power-max/Three-Half-Bridges/(threads)

Thread 1 (2020-09-15):

Add RC snubber network

power-max, 2020-09-15:
While Body diode and D3 and D5 clamp the maximum voltage at the output to [GND - VCC], it is still necessary to prevent high dv/dt causing excessive current to flow through Cgd (See: miller effect) and such an RC network can help limit the dv/dt observed across Vds of both FETs during operation when driving an inductive load.

Thread 2 (2020-09-15):

Place MOSFETs closer to heatsinks

power-max, 2020-09-15:
Found that the MOSFETs need to have the legs bend forward a bit to sit flush against the heatsink. Not a big deal but does make it a bit harder to assemble.

Thread 3 (2020-09-15):

Add descriptive silkscreen

power-max, 2020-09-15:
Forgot to add silkscreen designations.

* VCC connection (or should change to using VDD term since this is mostly FET and CMOS...)
* GND connection
* OUT connection

* Label FAN connection
* Label the signal and 12V connections

Closed 2024-11-10.

Thread 4 (2024-11-18):

Safety note

power-max, 2024-11-18:
Add note on PCB file and schematic that strictly TO-247 should be used and that TO-3P is not a great choice unless all three half bridges will be run in phase with each-other. There is not much clearance between adjacent half bridges and the exposed metal tab around the corners of the TO-3P causes an issue. SOT83 / TO218 should absolutely not be used!!!! TO218 is retarded. Not only does it have that issue but the smaller plastic package prevents the sandwich structure from providing any pressure on the tab.

Thread 5 (2024-11-19):

Designators update

power-max, 2024-11-19:
Replace D with Z for zener diodes, makes it easier to identify LED vs Zener diode footprint.

Closed 2024-11-25.

Thread 7 (2024-11-20):

Fix transformer footprint

power-max, 2024-11-20:
Update footprint for smaller transformer

power-max, 2024-11-25:
choose a less shitty transformer with better volt-time product or rethink driver mayhaps

Closed 2024-11-25.

Thread 8 (2024-11-20):

Change output rectification to double output voltage

power-max, 2024-11-20:
6505 and similar have 5V max input, update design to use several 6505's and 5V only primary side (eliminate 12V input)

Closed 2024-11-25.

Thread 9 (2024-11-20):

Add Pgood signal to 5V on primary and low voltage secondary

power-max, 2024-11-20:
In the event the 5V primary goes below UV lockout (something blew up?) Sends a signal back to controller to indicate fault condition

Thread 10 (2024-11-22):

Wrong pinout all LDOs

power-max, 2024-11-22:
So it turns out the pinout for the 78L05 in a SOT89 footprint is different from that of the AMS1117-5, and I can't find AMS1117-5 available in a SOT89, only a SOT-223. Guhhhhhh....... So update to feature a 78L05 instead.

Also, move regulators for the digital isolator ICs closer to them, no need to take precious space where the H bridge outputs are.

Closed 2024-11-25.

Thread 11 (2024-11-23):

Connect gate driver EN pins

power-max, 2024-11-23:
Add connections to gate driver ENABLE pins to enable or disable the gate driver provided via a solderbridge selectable footprint

Closed 2024-11-25.

Thread 13 (2024-11-24):

Wrong transformer footprint

power-max, 2024-11-24:
Gonna use the EPC3668G moving forward.

power-max, 2024-11-24:
and whatever transformer happens to fit that footprint :P

Closed 2024-11-25.

Thread 14 (2024-11-25):

soldermask removal on hall current sensors

power-max, 2024-11-25:
Passing over 60A through 2 pins of a SOIC8 is dodgy as is! Remove the solder mask on the 3 current sense

Closed 2024-11-25.

Thread 15 (2024-12-05):

Move OUT 1 2 3 designators

power-max, 2024-12-05:
With the new footprint for M5 terminal blocks, silkscreen can be moved inside the footprint to prevent clipping of text.

Thread 16 (2024-12-05):

Fix footprint for terminal blocks

power-max, 2024-12-05:
The slots for each through hole need to be rotated 90 degrees to fit them properly.

Thread 17 (2024-12-05):

update schottky diode footprint to SOT23-3

power-max, 2024-12-05:
the footprint is a bit small as I am populating the board, requiring me to solder blob it in place. I think I accidentally used the wrong footprint for it in the project. Update the schematic, BOM, and PCB file.

Thread 18 (2024-12-05):

LED footprint

power-max, 2024-12-05:
Change cap 0805 footprint (unpolarized) to diode 0805 footprint so polarity is known when hand soldering.

Thread 19 (2024-12-13):

Feature add: voltage sense

power-max, 2024-12-13:
Add voltage sense to output to allow more motor control algorithms

Sensorless 6 step block comutation of BLDC and PMSM can be done by using specialized SVM where ⅔ phases are driven and undriven phase is voltage sense waiting for zero or ½VCC crossing.

Thread 20 (2024-12-18):

Move TO243 high and low side closer together

power-max, 2024-12-18:
The packages tend to extend a bit beyond the edge of the heatsink. Also to reduce impedance between low side switch and high side body diode and vice versa.

Thread 23 (2025-01-02):

Change position of mounting screws to support mounting of a PWM computer chassis fan

power-max, 2025-01-02:
The 88mm hole spacing is quite close to a common standard 92mm PC case fan featuring 82.5mm hole spacing, allowing standoffs to be mounted and a fan mounted.

Thread 24 (2025-03-22):

add design rules for voltage domains

power-max, 2025-03-22:
Add design rules for the HV and LV voltage domains to enforce adequate creepage and clearance ensuring at least some basic level of safety. (safety last!)
