power-max/Three-Half-Bridges/pdf/three_half_bridges.pdf

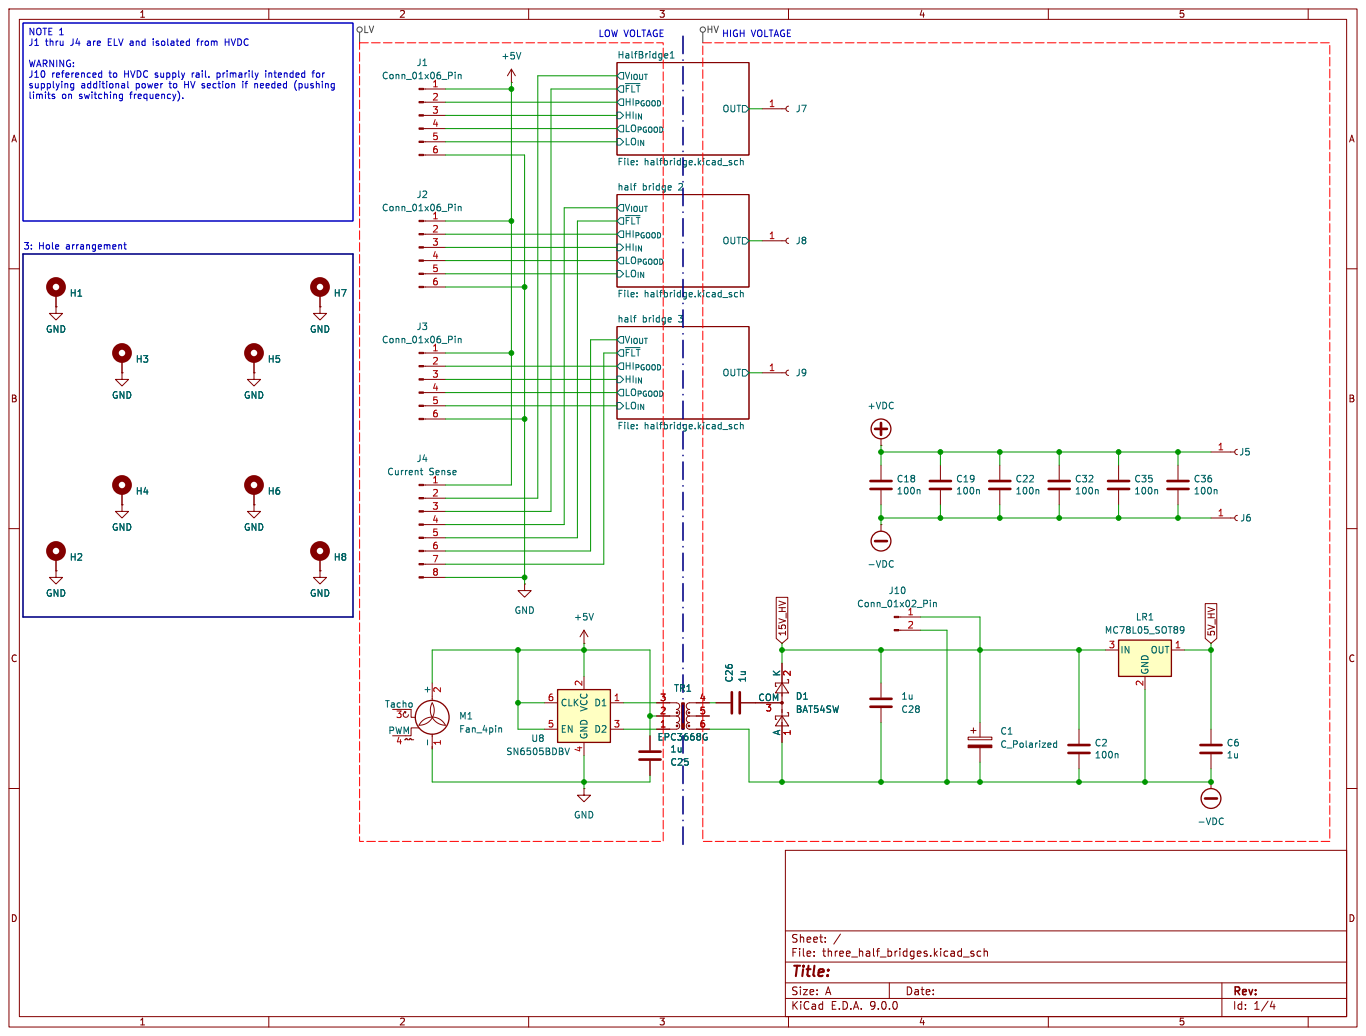
[picture p1: page 1]

~{FLT} half bridge 3 File: halfbridge.kicad_schOUT HI_{IN}
LO_{PGOOD}

Id: 1/4 Title: File: three_half_bridges.kicad_sch Sheet: /

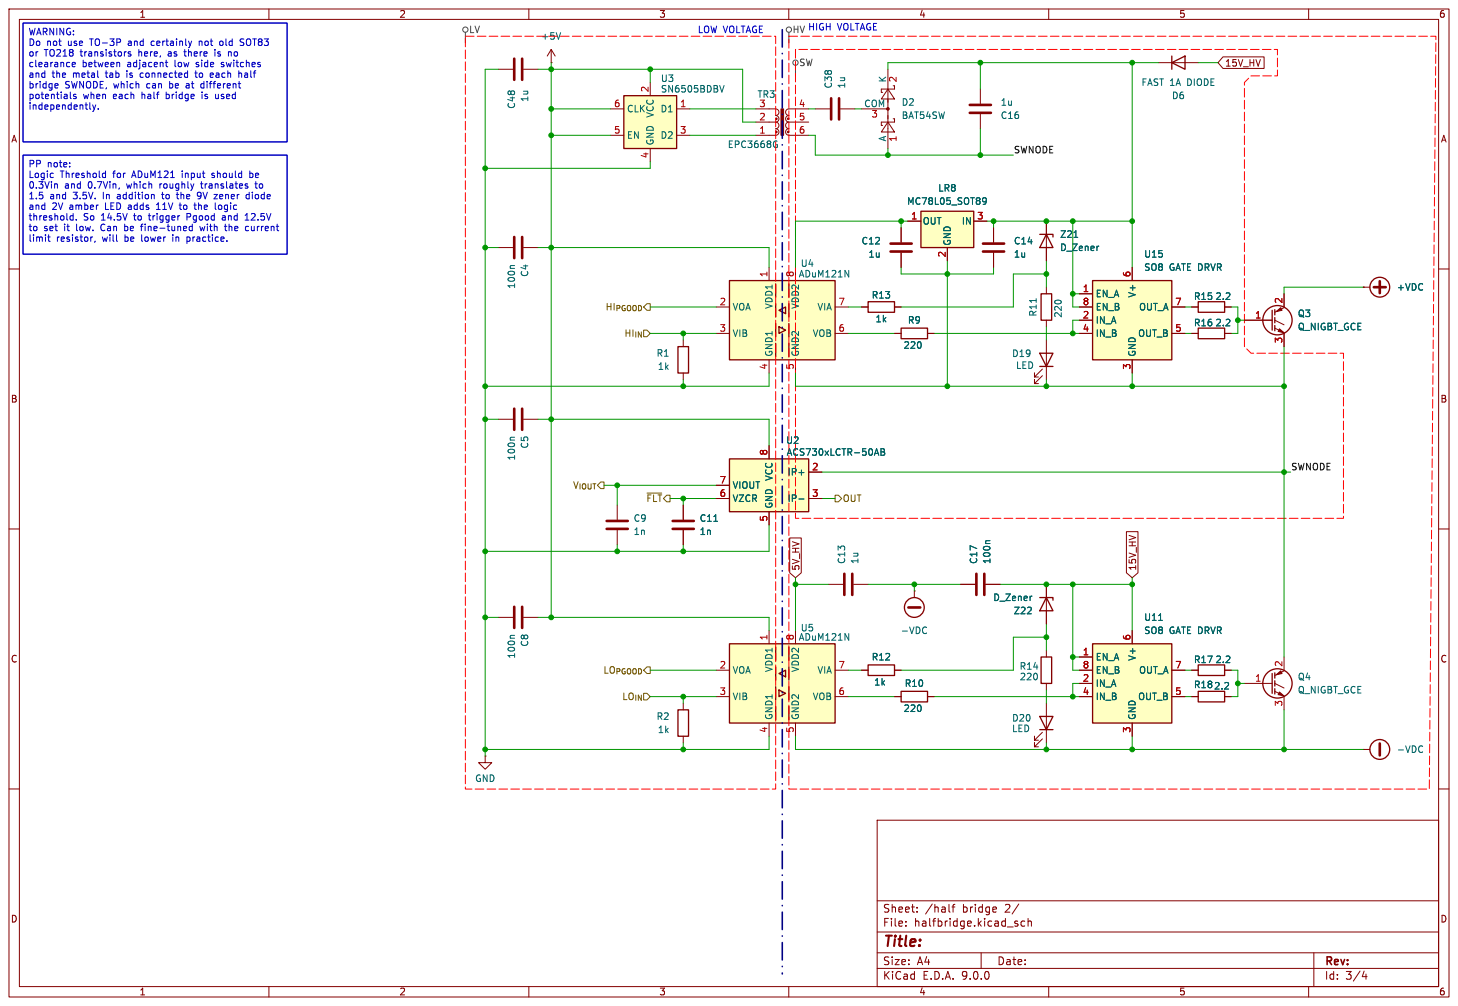
[picture p2: page 2]

5 VIA 7 VOB 6 U4 ADuM121NC38 1u D6 FAST 1A DIODE R9

PP note: Logic Threshold for ADuM121 input should be

and 2V amber LED adds 11V to the logic

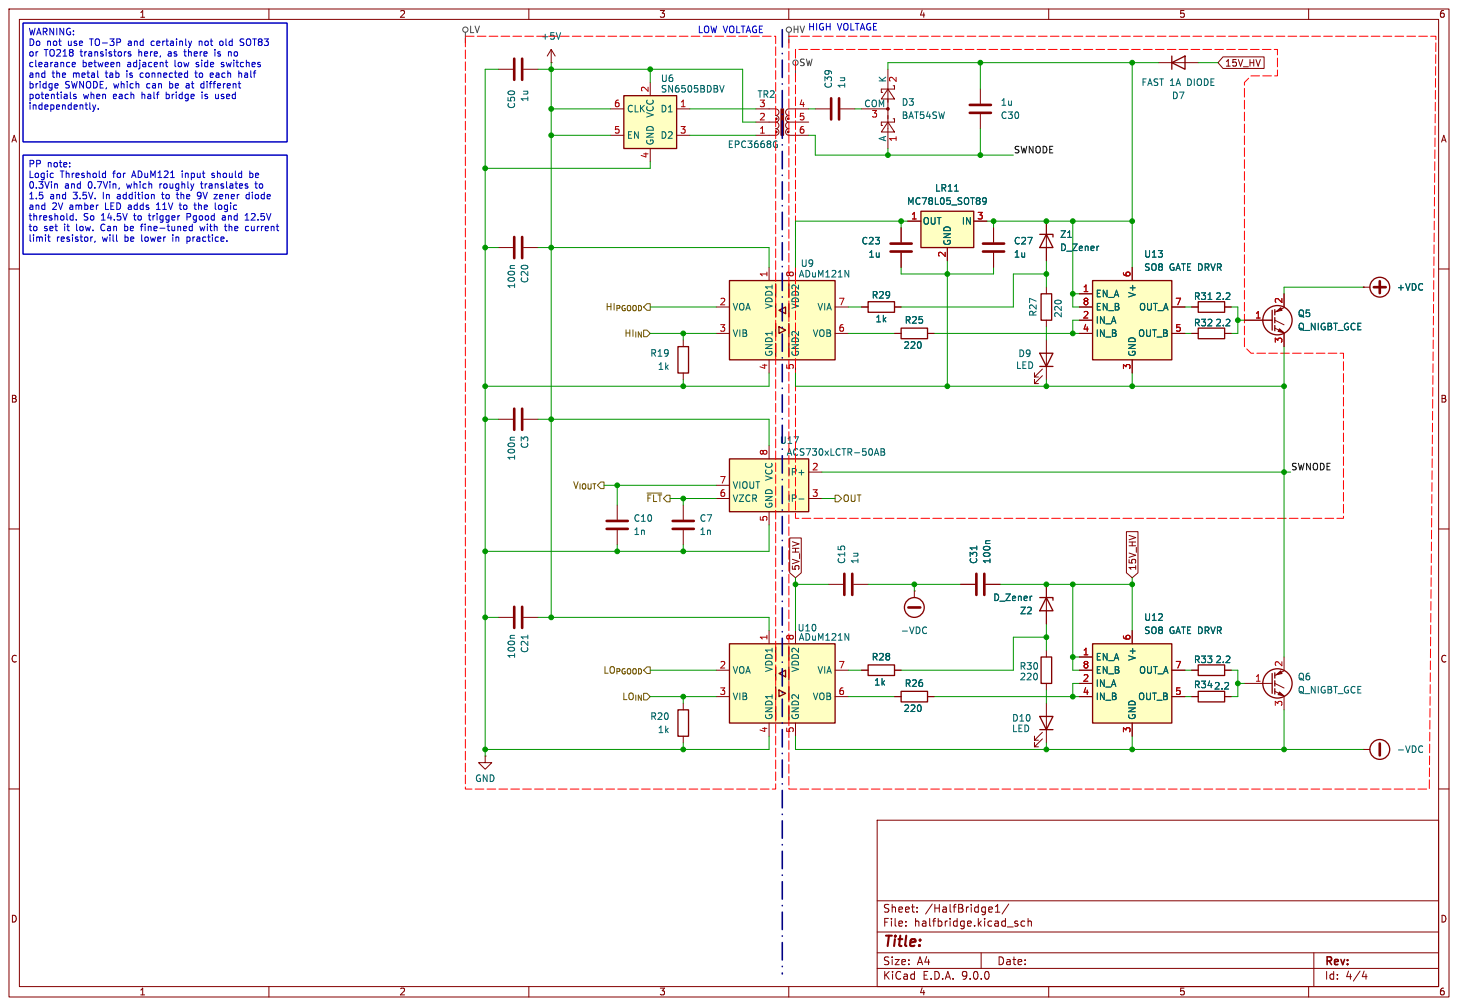
[picture p3: page 3]

4 D1 1 D2 3 U6SN6505BDBV R34 2.2 C20 100n R20
Id: 4/4 Title: File: halfbridge.kicad_sch Sheet: /HalfBridge1/ C501u
1u GND

PP note: Logic Threshold for ADuM121 input should be

and 2V amber LED adds 11V to the logic

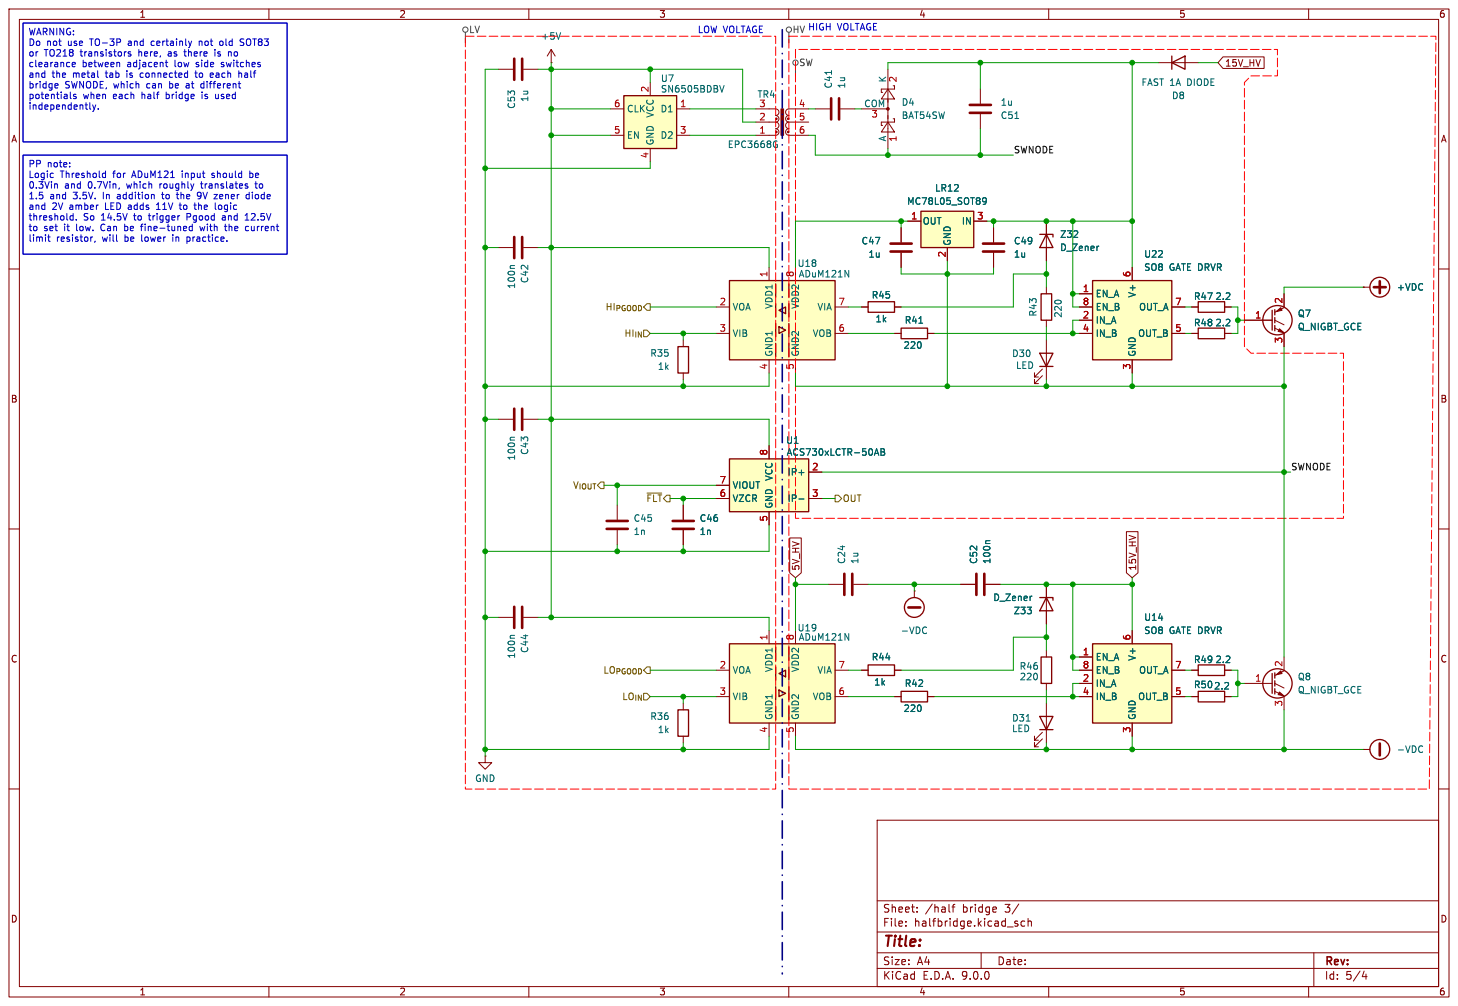
[picture p4: page 4]

PP note: Logic Threshold for ADuM121 input should be

and 2V amber LED adds 11V to the logic
