power-max/Three-Half-Bridges/pdf/three_half_bridges-B_Cu.pdf

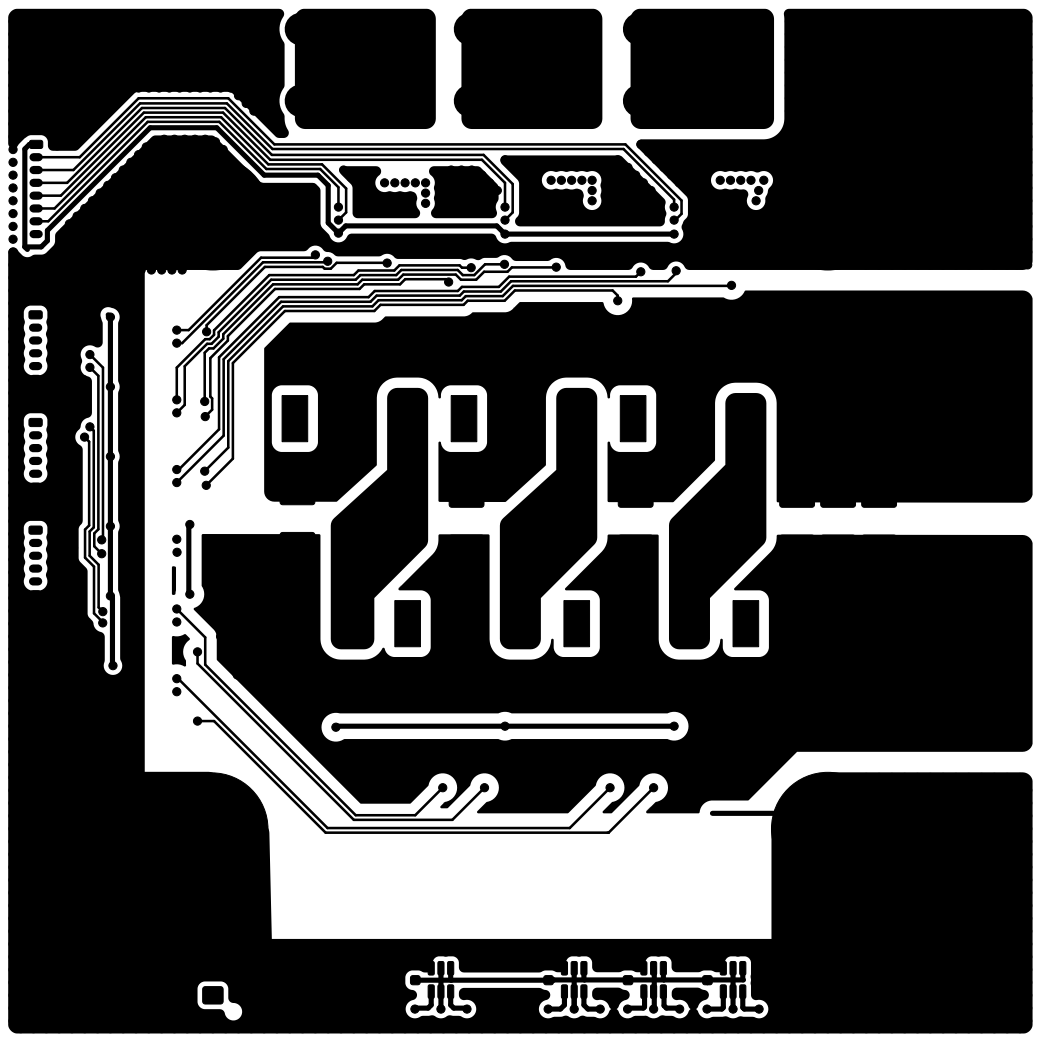
[picture p5: page 1]
