power-max/Three-Half-Bridges/pdf/three_half_bridges-B_Mask.pdf

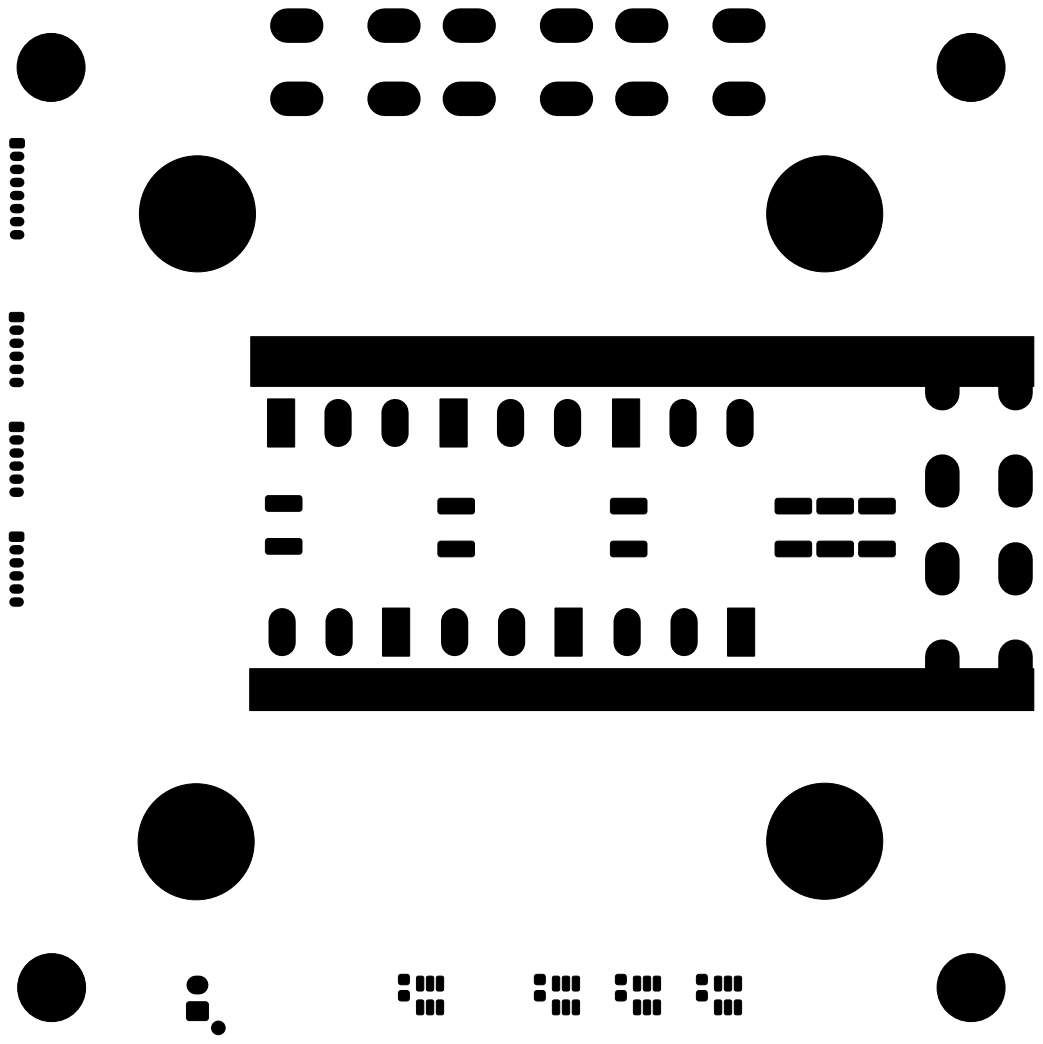
[picture p6: page 1]
