power-max/Three-Half-Bridges/pdf/three_half_bridges-B_Paste.pdf

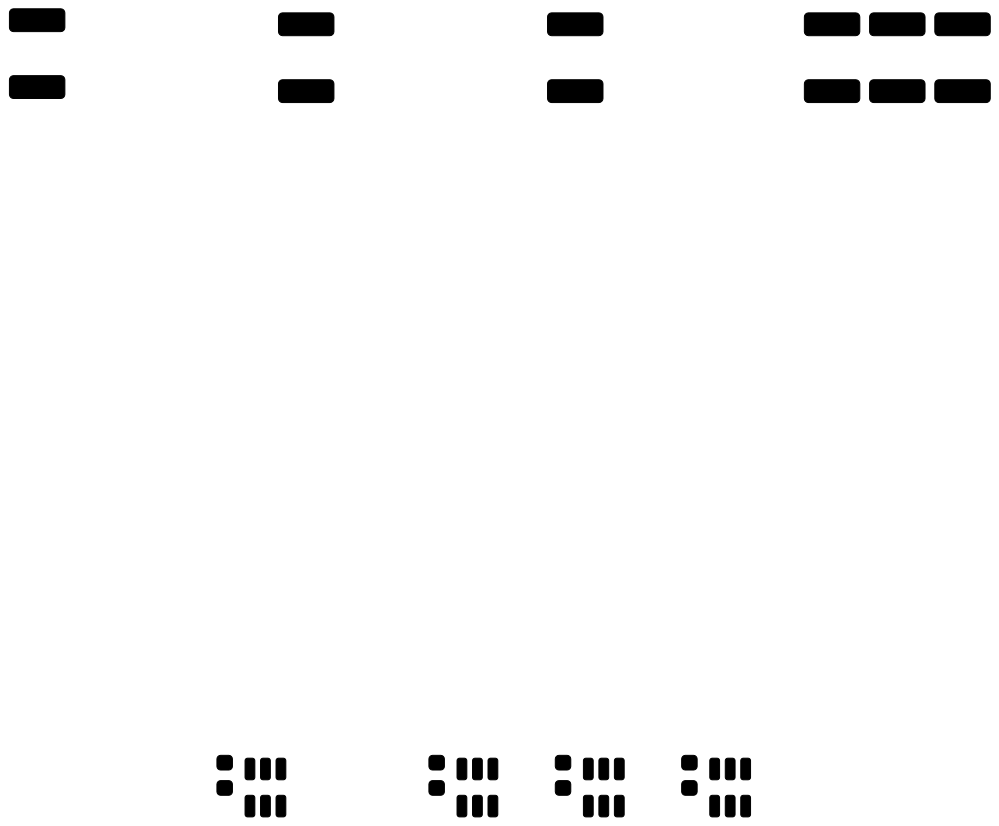
[picture p7: page 1]
