power-max/Three-Half-Bridges/pdf/three_half_bridges-B_Silkscreen.pdf

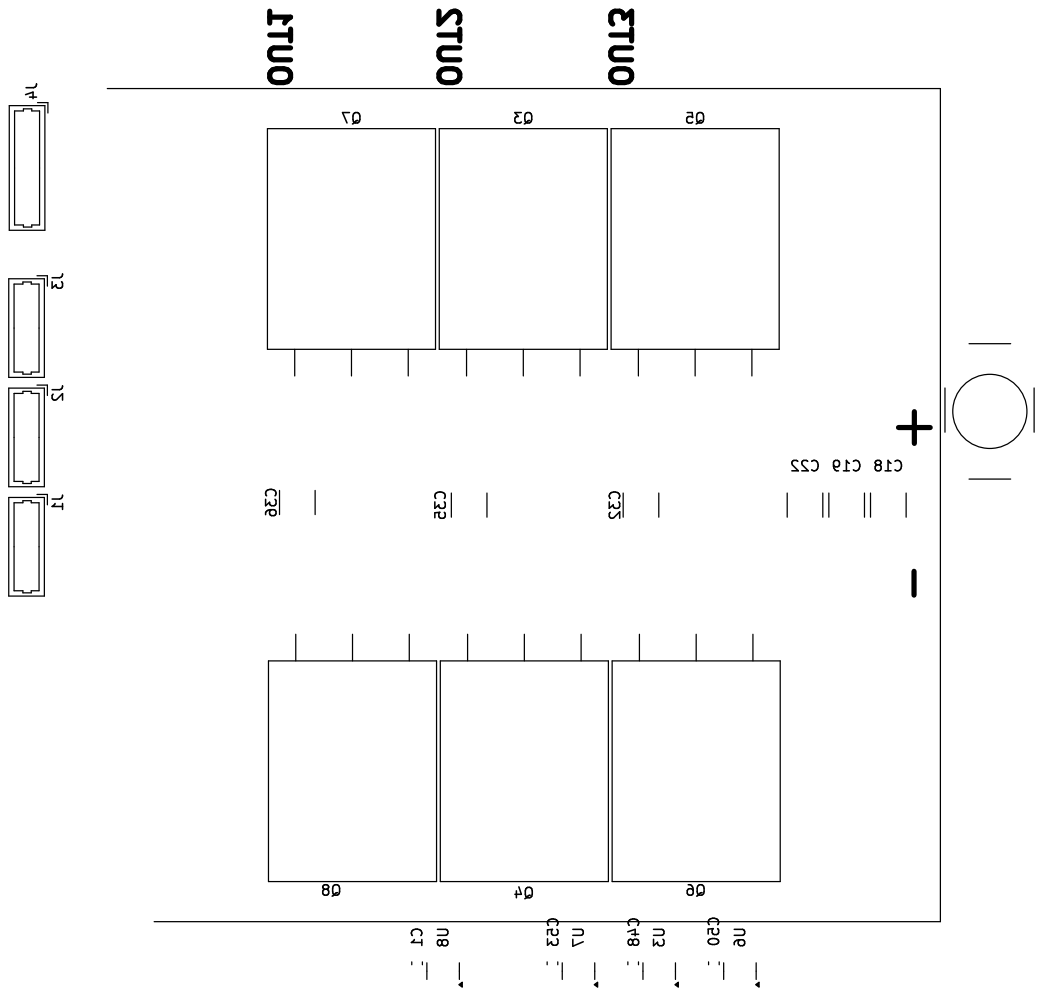
[picture p8: page 1]
