power-max/Three-Half-Bridges/pdf/three_half_bridges-F_Cu.pdf

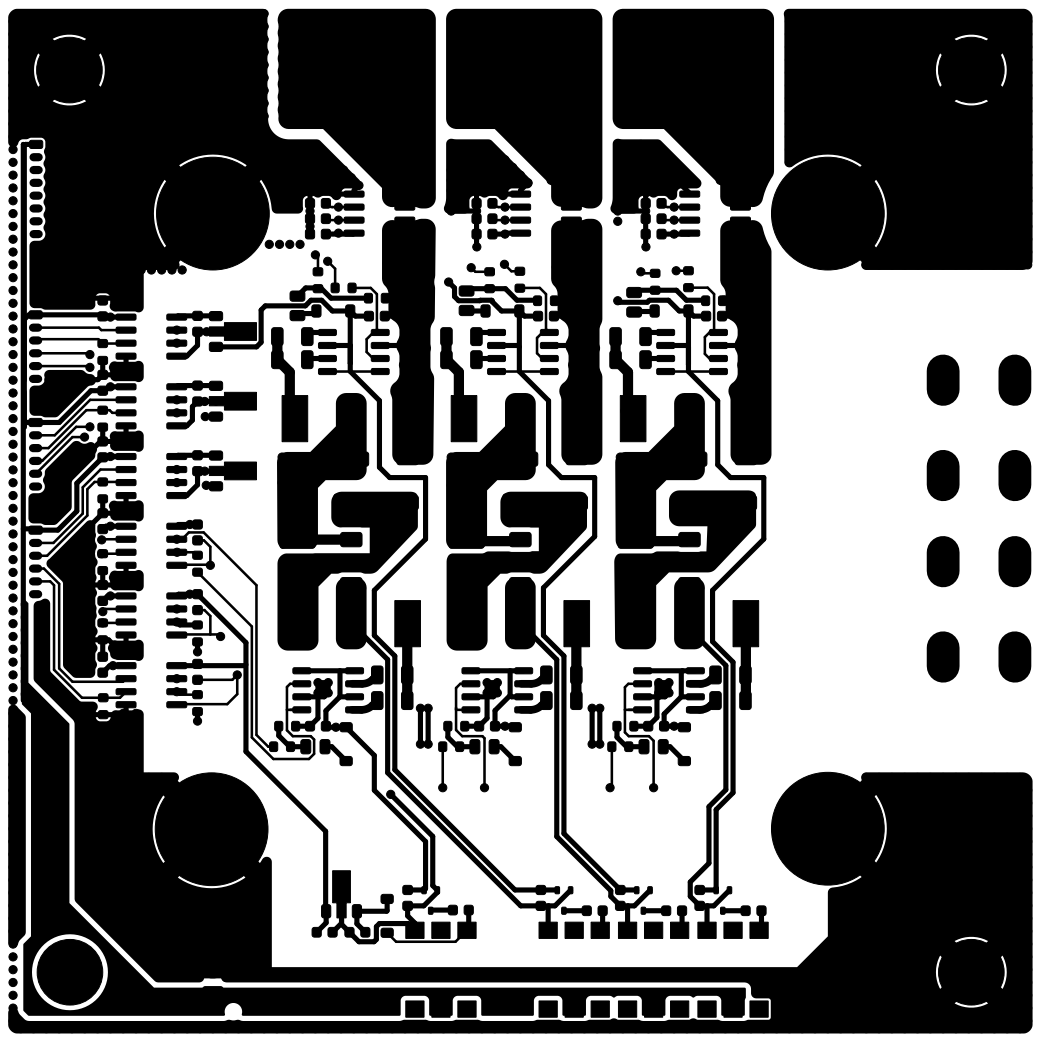
[picture p9: page 1]
