power-max/Three-Half-Bridges/pdf/three_half_bridges-F_Mask.pdf

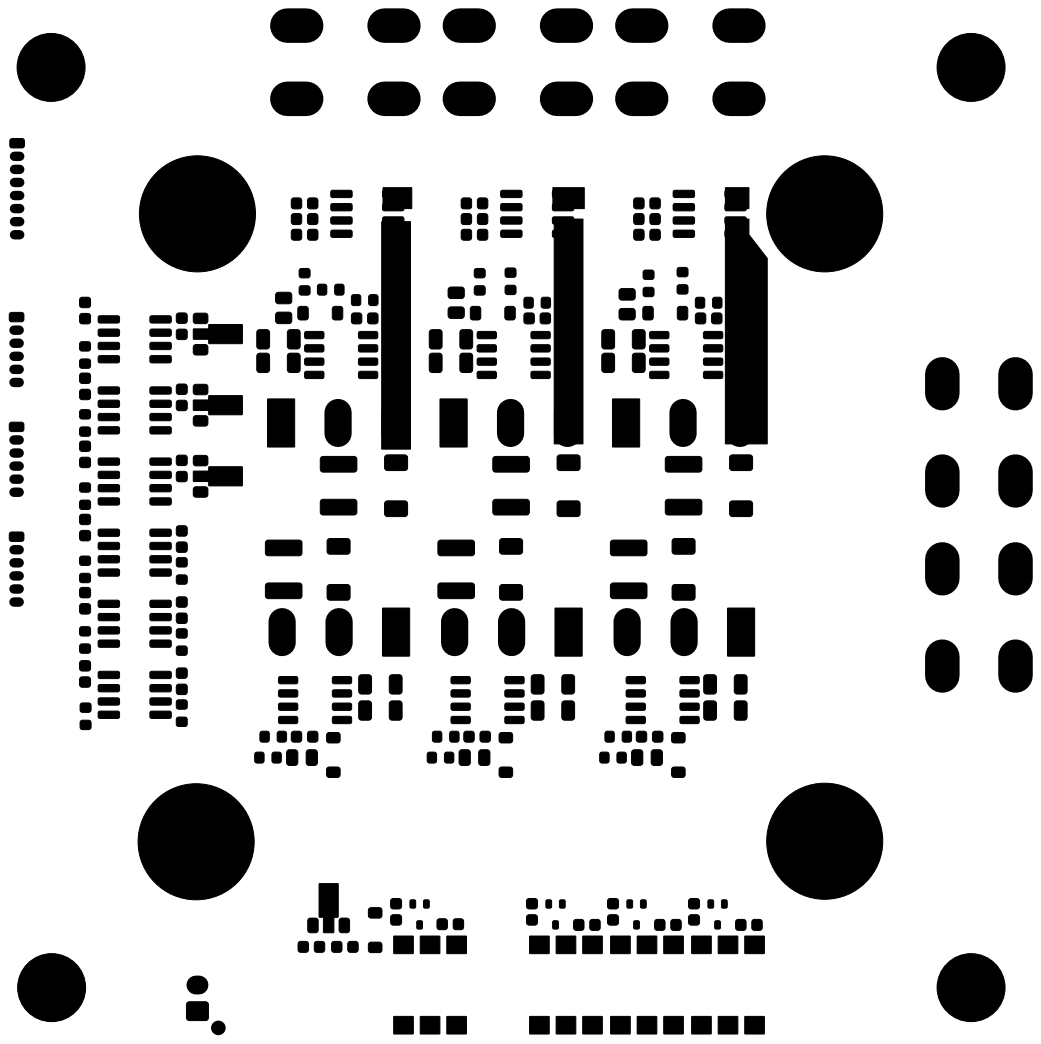
[picture p10: page 1]
