power-max/Three-Half-Bridges/pdf/three_half_bridges-F_Paste.pdf

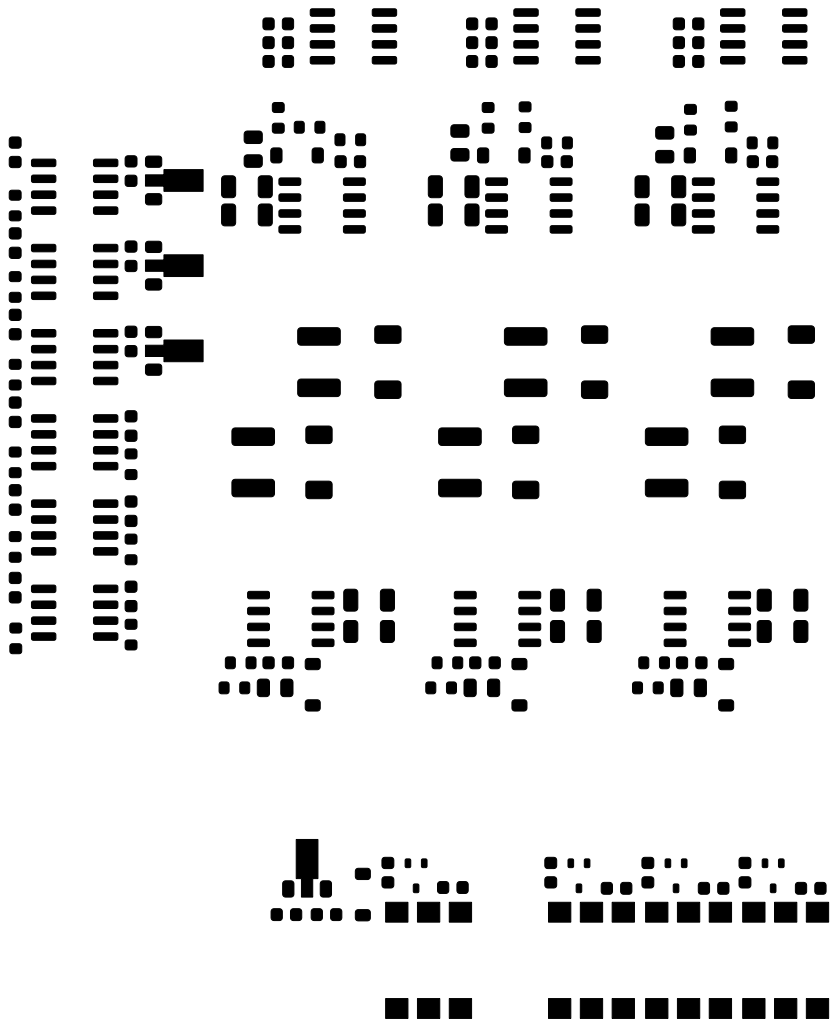
[picture p11: page 1]
