power-max/Three-Half-Bridges/pdf/three_half_bridges-F_Silkscreen.pdf

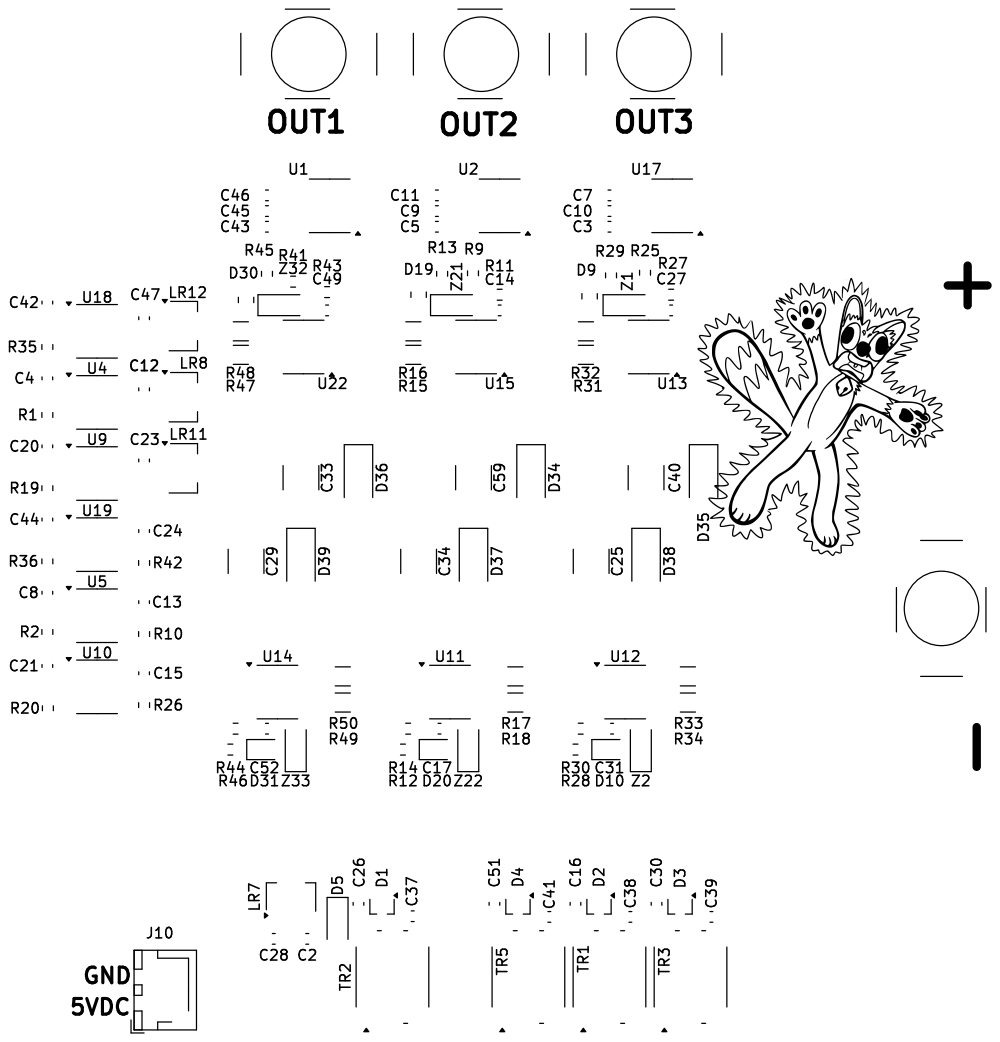
[picture p12: page 1]
