power-max/Three-Half-Bridges/pdf/three_half_bridges-In1_Cu.pdf

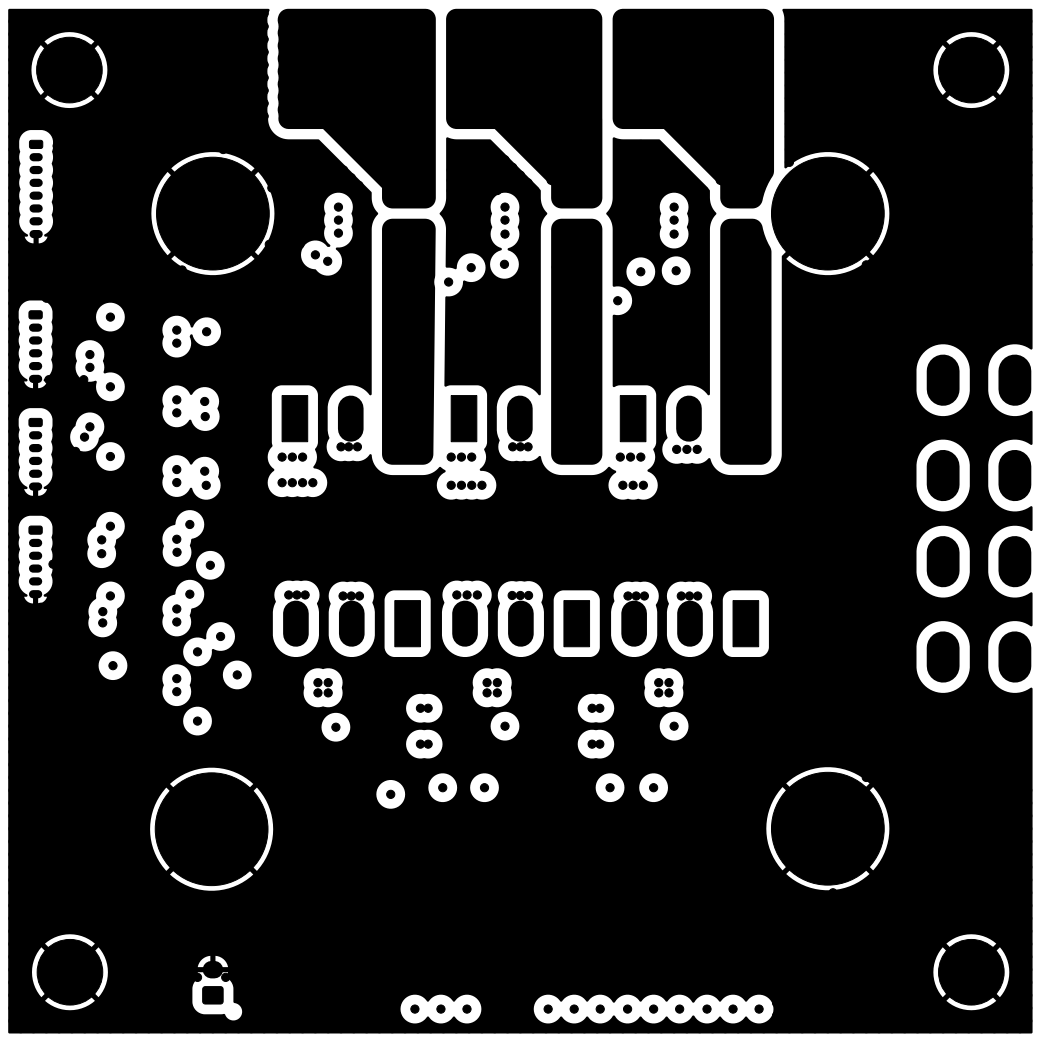
[picture p13: page 1]
