power-max/Three-Half-Bridges/pdf/three_half_bridges-In2_Cu.pdf

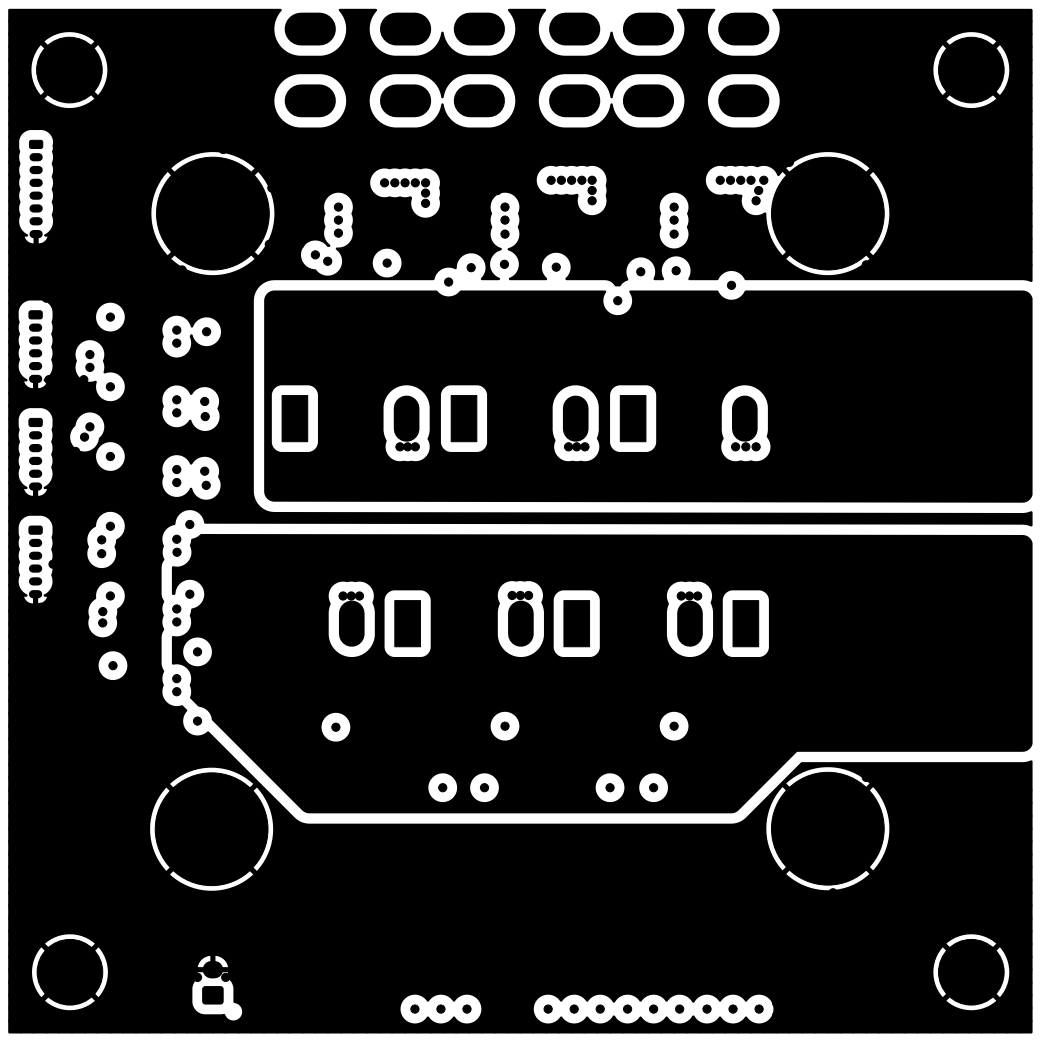
[picture p14: page 1]
