power-max/Three-Half-Bridges/three_half_bridges.kicad_pcb

## KiCad design three_half_bridges.kicad_pcb (2025-03-26)

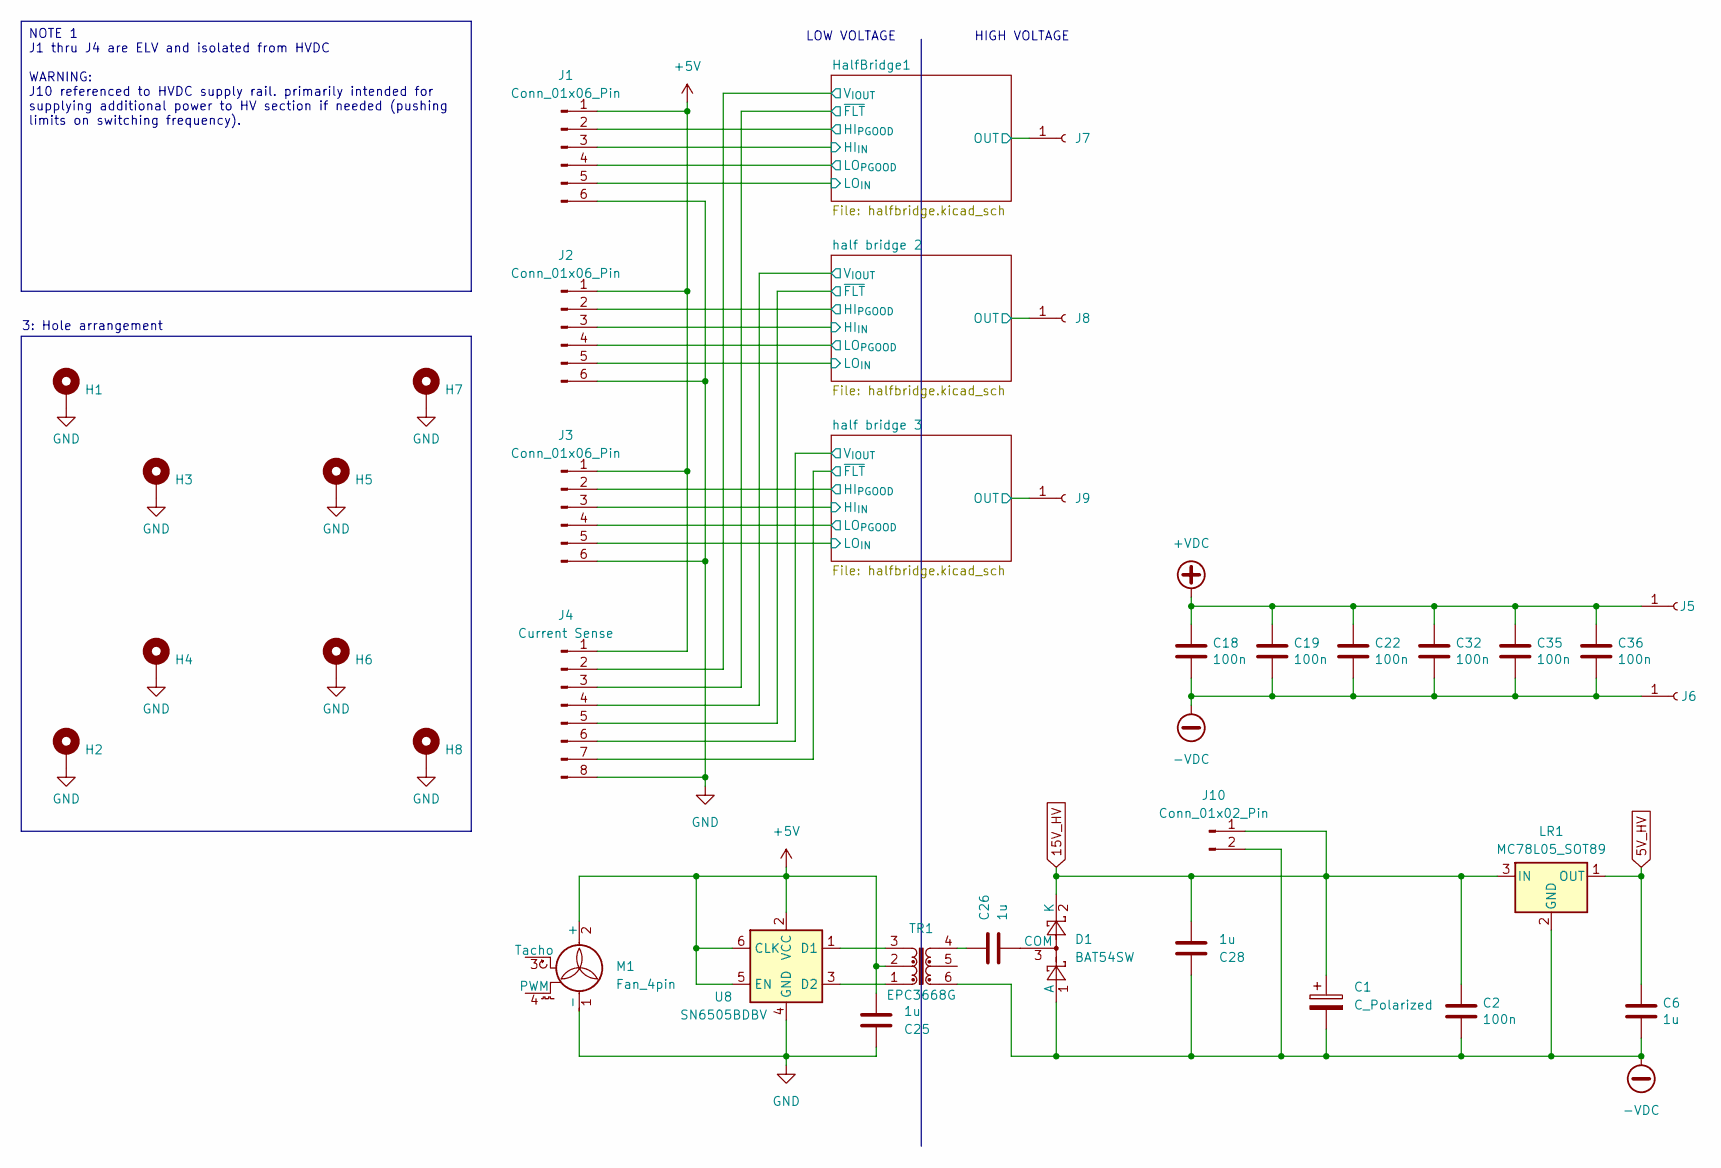
[picture p15: schematic three_half_bridges.kicad_sch]

Parts:
C1: C_Polarized; CP_EIA-6032-20_AVX-F
C2: 100n; C_0805_2012Metric
C6: 1u; C_0805_2012Metric
C18, C19, C22, C32, C35, C36: 100n; C_1812_4532Metric
C25, C26, C28: 1u; C_0603_1608Metric
D1: BAT54SW; SOT-323_SC-70
H1, H2, H7, H8: MountingHole_Pad; MountingHole_3.2mm_M3_Pad_Via
H3, H4, H5, H6: MountingHole_Pad; MountingHole_5.5mm_Pad_Via
J1, J2, J3: Conn_01x06_Pin; Molex_PicoBlade_53047-0610_1x06_P1.25mm_Vertical
J4: Current Sense; Molex_PicoBlade_53047-0810_1x08_P1.25mm_Vertical
J5, J6, J7, J8, J9: Conn_01x01_Socket; AMT0450028DB0000G
J10: Conn_01x02_Pin; JST_XH_B2B-XH-A_1x02_P2.50mm_Vertical
LR1: MC78L05_SOT89; SOT-89-3
M1: Fan_4pin; Molex_KK-254_AE-6410-04A_1x04_P2.54mm_Vertical
TR1: EPC3668G; Pulse_PA2004NL
U8: SN6505BDBV; SOT-23-6

Connections:
5V_HV: C6.2, LR1.1 (OUT); also elsewhere on the board
15V_HV: C1.1, C2.2, C28.2, D1.2 (K), J10.1, LR1.3 (IN); also elsewhere on the board
+5V: C25.2, J1.1, J2.1, J3.1, J4.1, M1.2 (+), TR1.2, U8.2 (VCC), U8.5 (EN), U8.6 (CLK); also elsewhere on the board
+VDC: C18.2, C19.2, C22.2, C32.2, C35.2, C36.2, J5.1; also elsewhere on the board
-VDC: C1.2, C2.1, C6.1, C18.1, C19.1, C22.1, C28.1, C32.1, C35.1, C36.1, D1.1 (A), J6.1, J10.2, LR1.2 (GND), TR1.6; also elsewhere on the board
/half bridge 1/HI_{IN}: J1.3; also elsewhere on the board
/half bridge 1/HI_{PGOOD}: J1.2; also elsewhere on the board
/half bridge 1/LO_{IN}: J1.5; also elsewhere on the board
/half bridge 1/LO_{PGOOD}: J1.4; also elsewhere on the board
/half bridge 1/OUT: J7.1; also elsewhere on the board
/half bridge 1/V_{IOUT}: J4.2; also elsewhere on the board
/half bridge 1/~FLT: J4.3; also elsewhere on the board
/half bridge 2/HI_{IN}: J2.3; also elsewhere on the board
/half bridge 2/HI_{PGOOD}: J2.2; also elsewhere on the board
/half bridge 2/LO_{IN}: J2.5; also elsewhere on the board
/half bridge 2/LO_{PGOOD}: J2.4; also elsewhere on the board
/half bridge 2/OUT: J8.1; also elsewhere on the board
/half bridge 2/V_{IOUT}: J4.4; also elsewhere on the board
/half bridge 2/~FLT: J4.5; also elsewhere on the board
/half bridge 3/HI_{IN}: J3.3; also elsewhere on the board
/half bridge 3/HI_{PGOOD}: J3.2; also elsewhere on the board
/half bridge 3/LO_{IN}: J3.5; also elsewhere on the board
/half bridge 3/LO_{PGOOD}: J3.4; also elsewhere on the board
/half bridge 3/OUT: J9.1; also elsewhere on the board
/half bridge 3/V_{IOUT}: J4.6; also elsewhere on the board
/half bridge 3/~FLT: J4.7; also elsewhere on the board
GND: C25.1, H1.1, H2.1, H3.1, H4.1, H5.1, H6.1, H7.1, H8.1, J1.6, J2.6, J3.6, J4.8, M1.1 (-), U8.4 (GND); also elsewhere on the board
unnamed: C26.1, TR1.4
unnamed: C26.2, D1.3 (COM)
unnamed: TR1.3, U8.1 (D1)
unnamed: TR1.1, U8.3 (D2)

Notes on the sheet:
LOW VOLTAGE
HIGH VOLTAGE
3: Hole arrangement
NOTE 1 J1 thru J4 are ELV and isolated from HVDC WARNING: J10 referenced to HVDC supply rail. primarily intended for supplying additional power to HV section if needed (pushing limits on switching frequency).

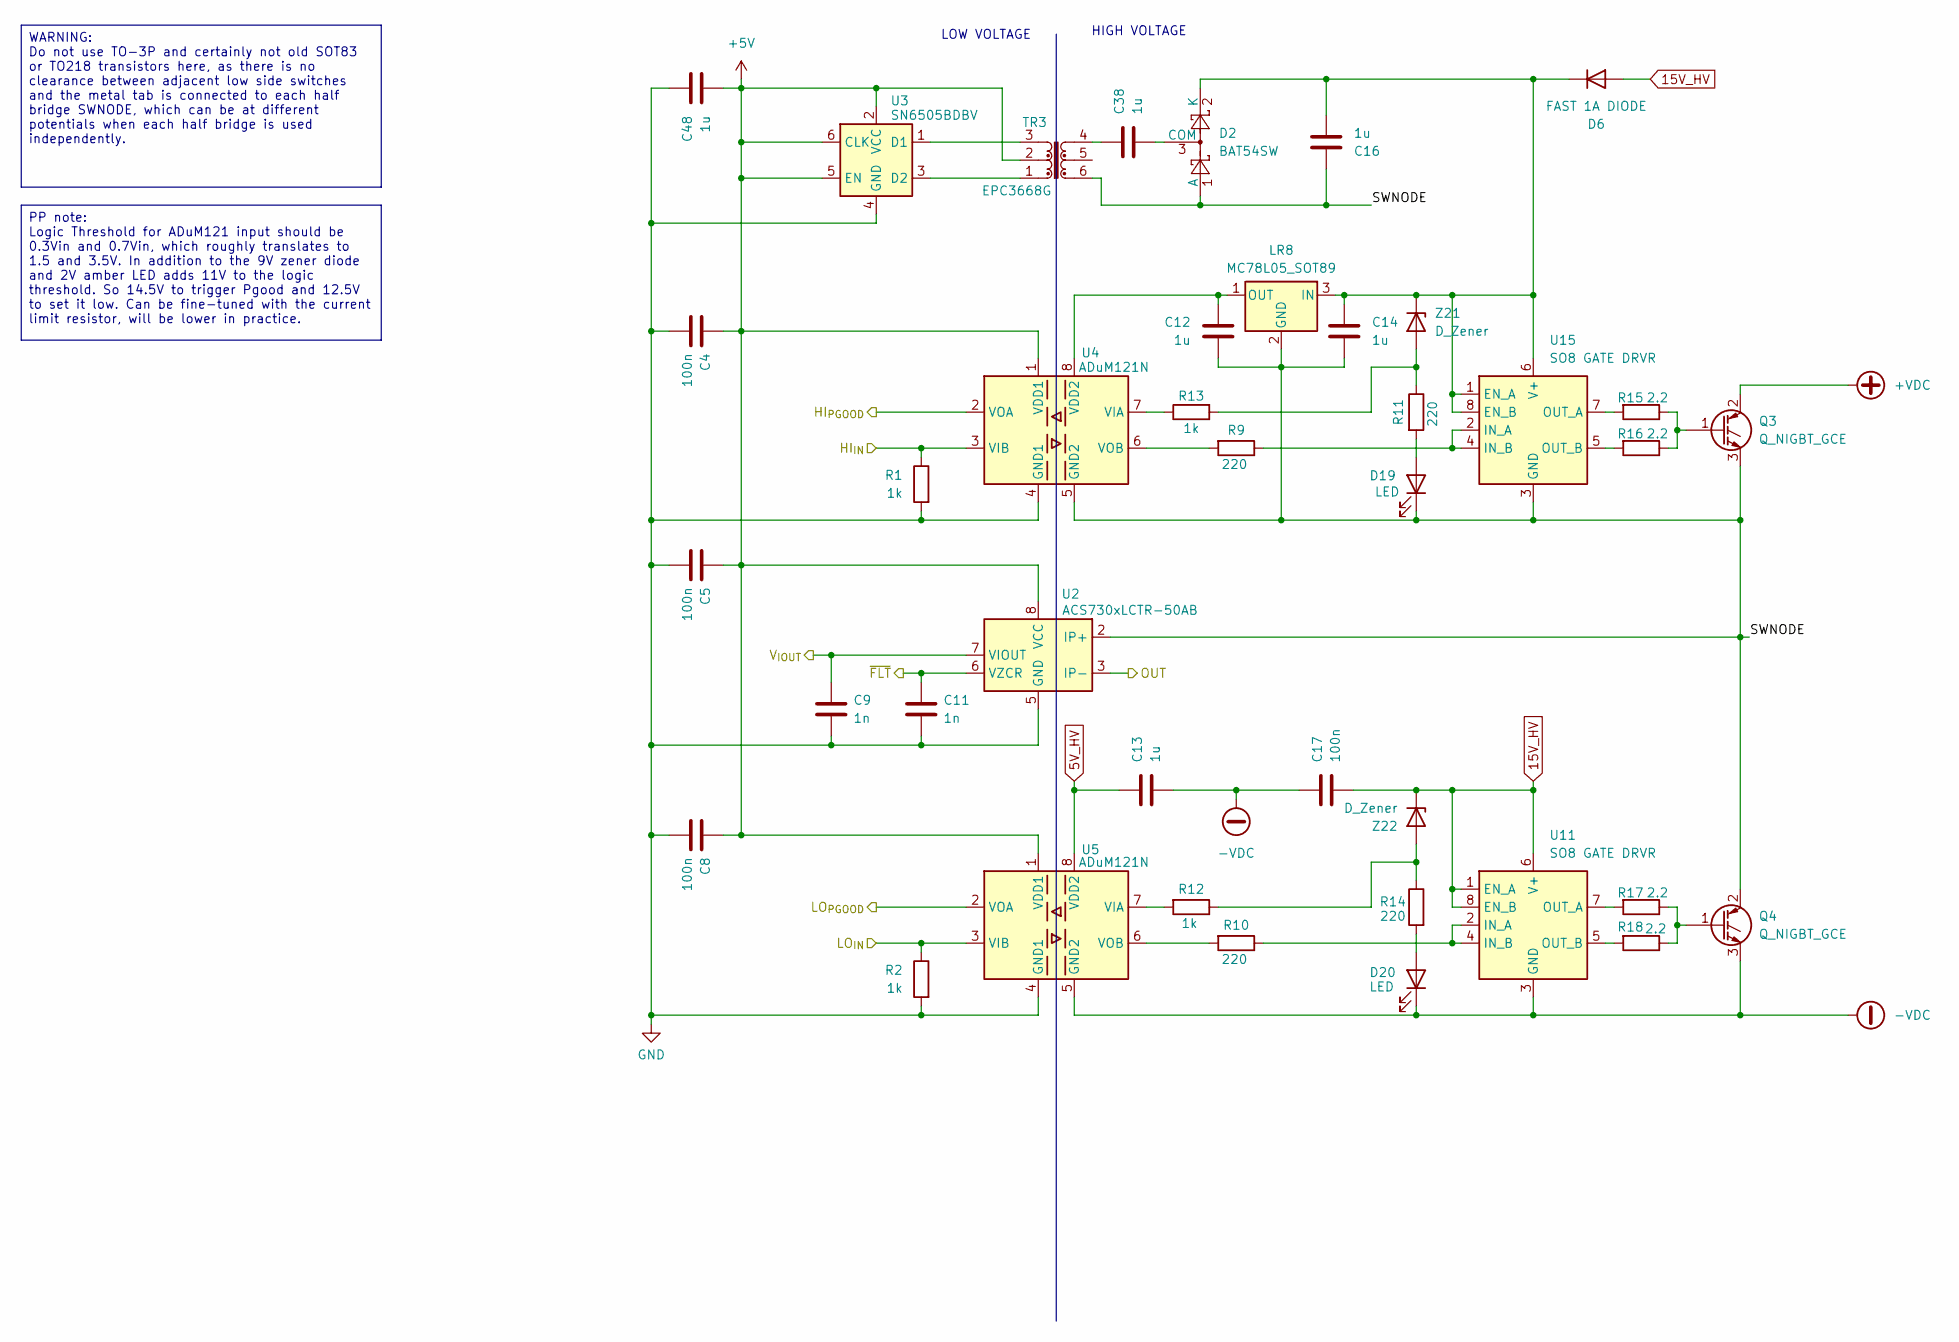
[picture p16: schematic halfbridge.kicad_sch]

Parts:
C4, C5, C8, C17: 100n; C_0603_1608Metric
C9, C11: 1n; C_0603_1608Metric
C12, C13, C14, C16, C38, C48: 1u; C_0603_1608Metric
D2: BAT54SW; SOT-323_SC-70
D6: FAST 1A DIODE; D_SOD-128
D19, D20: LED; LED_0805_2012Metric
LR8: MC78L05_SOT89; SOT-89-3
Q3, Q4: Q_NIGBT_GCE; TO-247-3-Nogloryhole_Horizontal_TabUp
R1, R2, R12, R13: 1k; R_0603_1608Metric
R9, R10, R11, R14: 220; R_0603_1608Metric
R15, R16, R17, R18: 2.2; R_1206_3216Metric
TR3: EPC3668G; Pulse_PA2004NL
U2: ACS730xLCTR-50AB; SOIC-8_3.9x4.9mm_P1.27mm
U3: SN6505BDBV; SOT-23-6
U4, U5: ADuM121N; SOIC-8_3.9x4.9mm_P1.27mm
U11, U15: SO8 GATE DRVR; SO-8_3.9x4.9mm_P1.27mm
Z21, Z22: D_Zener; D_SOD-123

Connections:
5V_HV: C13.1, U5.8 (VDD2); also elsewhere on the board
15V_HV: C17.2, D6.2 (A), U11.1 (EN_A), U11.6 (V+), U11.8 (EN_B), Z22.1 (K); also elsewhere on the board
+5V: C4.1, C5.1, C8.1, C48.2, TR3.2, U2.8 (VCC), U3.2 (VCC), U3.5 (EN), U3.6 (CLK), U4.1 (VDD1), U5.1 (VDD1); also elsewhere on the board
+VDC: Q3.2 (C); also elsewhere on the board
-VDC: C13.2, C17.1, D20.1 (K), Q4.3 (E), U5.5 (GND2), U11.3 (GND); also elsewhere on the board
/half bridge 2/HI_{IN}: R1.1, U4.3 (VIB); also elsewhere on the board
/half bridge 2/HI_{PGOOD}: U4.2 (VOA); also elsewhere on the board
/half bridge 2/LO_{IN}: R2.1, U5.3 (VIB); also elsewhere on the board
/half bridge 2/LO_{PGOOD}: U5.2 (VOA); also elsewhere on the board
/half bridge 2/OUT: U2.3 (IP-), U2.4 (IP-); also elsewhere on the board
/half bridge 2/SWNODE: C12.2, C14.2, C16.1, D2.1 (A), D19.1 (K), LR8.2 (GND), Q3.3 (E), Q4.2 (C), TR3.6, U2.1 (IP+), U2.2 (IP+), U4.5 (GND2), U15.3 (GND)
/half bridge 2/V_{IOUT}: C9.1, U2.7 (VIOUT); also elsewhere on the board
/half bridge 2/~FLT: C11.1, U2.6 (VZCR); also elsewhere on the board
GND: C4.2, C5.2, C8.2, C9.2, C11.2, C48.1, R1.2, R2.2, U2.5 (GND), U3.4 (GND), U4.4 (GND1), U5.4 (GND1); also elsewhere on the board
unnamed: C38.1, TR3.4
unnamed: C38.2, D2.3 (COM)
unnamed: C14.1, C16.2, D2.2 (K), D6.1 (K), LR8.3 (IN), U15.1 (EN_A), U15.6 (V+), U15.8 (EN_B), Z21.1 (K)
unnamed: D19.2 (A), R11.2
unnamed: D20.2 (A), R14.2
unnamed: C12.1, LR8.1 (OUT), U4.8 (VDD2)
unnamed: Q3.1 (G), R15.1, R16.1
unnamed: Q4.1 (G), R17.1, R18.1
unnamed: TR3.3, U3.1 (D1)
unnamed: TR3.1, U3.3 (D2)
unnamed: R13.1, U4.7 (VIA)
unnamed: R9.2, U4.6 (VOB)
unnamed: R12.2, U5.7 (VIA)
unnamed: R10.2, U5.6 (VOB)
unnamed: R10.1, U11.2 (IN_A), U11.4 (IN_B)
unnamed: R17.2, U11.7 (OUT_A)
unnamed: R18.2, U11.5 (OUT_B)
unnamed: R9.1, U15.2 (IN_A), U15.4 (IN_B)
unnamed: R15.2, U15.7 (OUT_A)
unnamed: R16.2, U15.5 (OUT_B)
unnamed: R11.1, R13.2, Z21.2 (A)
unnamed: R12.1, R14.1, Z22.2 (A)

Parts of its further copies:
C3, C20, C21, C31, C42, C43, C44, C52: 100n; C_0603_1608Metric
C7, C10, C45, C46: 1n; C_0603_1608Metric
C15, C23, C24, C27, C30, C39, C41, C47, C49, C50, C51, C53: 1u; C_0603_1608Metric
D3, D4: BAT54SW; SOT-323_SC-70
D7, D8: FAST 1A DIODE; D_SOD-128
D9, D10, D30, D31: LED; LED_0805_2012Metric
LR11, LR12: MC78L05_SOT89; SOT-89-3
Q5, Q6, Q7, Q8: Q_NIGBT_GCE; TO-247-3-Nogloryhole_Horizontal_TabUp
R19, R20, R28, R29, R35, R36, R44, R45: 1k; R_0603_1608Metric
R25, R26, R27, R30, R41, R42, R43, R46: 220; R_0603_1608Metric
R31, R32, R33, R34, R47, R48, R49, R50: 2.2; R_1206_3216Metric
TR2, TR4: EPC3668G; Pulse_PA2004NL
U1, U17: ACS730xLCTR-50AB; SOIC-8_3.9x4.9mm_P1.27mm
U6, U7: SN6505BDBV; SOT-23-6
U9, U10, U18, U19: ADuM121N; SOIC-8_3.9x4.9mm_P1.27mm
U12, U13, U14, U22: SO8 GATE DRVR; SO-8_3.9x4.9mm_P1.27mm
Z1, Z2, Z32, Z33: D_Zener; D_SOD-123

Connections of its further copies:
5V_HV: C15.1, C24.1, U10.8 (VDD2), U19.8 (VDD2); also elsewhere on the board
15V_HV: C31.2, C52.2, D7.2 (A), D8.2 (A), U12.1 (EN_A), U12.6 (V+), U12.8 (EN_B), U14.1 (EN_A), U14.6 (V+), U14.8 (EN_B), Z2.1 (K), Z33.1 (K); also elsewhere on the board
+5V: C3.1, C20.1, C21.1, C42.1, C43.1, C44.1, C50.2, C53.2, TR2.2, TR4.2, U1.8 (VCC), U6.2 (VCC), U6.5 (EN), U6.6 (CLK), U7.2 (VCC), U7.5 (EN), U7.6 (CLK), U9.1 (VDD1), U10.1 (VDD1), U17.8 (VCC), U18.1 (VDD1), U19.1 (VDD1); also elsewhere on the board
+VDC: Q5.2 (C), Q7.2 (C); also elsewhere on the board
-VDC: C15.2, C24.2, C31.1, C52.1, D10.1 (K), D31.1 (K), Q6.3 (E), Q8.3 (E), U10.5 (GND2), U12.3 (GND), U14.3 (GND), U19.5 (GND2); also elsewhere on the board
/half bridge 1/HI_{IN}: R19.1, U9.3 (VIB); also elsewhere on the board
/half bridge 1/HI_{PGOOD}: U9.2 (VOA); also elsewhere on the board
/half bridge 1/LO_{IN}: R20.1, U10.3 (VIB); also elsewhere on the board
/half bridge 1/LO_{PGOOD}: U10.2 (VOA); also elsewhere on the board
/half bridge 1/OUT: U17.3 (IP-), U17.4 (IP-); also elsewhere on the board
/half bridge 1/SWNODE: C23.2, C27.2, C30.1, D3.1 (A), D9.1 (K), LR11.2 (GND), Q5.3 (E), Q6.2 (C), TR2.6, U9.5 (GND2), U13.3 (GND), U17.1 (IP+), U17.2 (IP+)
/half bridge 1/V_{IOUT}: C10.1, U17.7 (VIOUT); also elsewhere on the board
/half bridge 1/~FLT: C7.1, U17.6 (VZCR); also elsewhere on the board
/half bridge 3/HI_{IN}: R35.1, U18.3 (VIB); also elsewhere on the board
/half bridge 3/HI_{PGOOD}: U18.2 (VOA); also elsewhere on the board
/half bridge 3/LO_{IN}: R36.1, U19.3 (VIB); also elsewhere on the board
/half bridge 3/LO_{PGOOD}: U19.2 (VOA); also elsewhere on the board
/half bridge 3/OUT: U1.3 (IP-), U1.4 (IP-); also elsewhere on the board
/half bridge 3/SWNODE: C47.2, C49.2, C51.1, D4.1 (A), D30.1 (K), LR12.2 (GND), Q7.3 (E), Q8.2 (C), TR4.6, U1.1 (IP+), U1.2 (IP+), U18.5 (GND2), U22.3 (GND)
/half bridge 3/V_{IOUT}: C45.1, U1.7 (VIOUT); also elsewhere on the board
/half bridge 3/~FLT: C46.1, U1.6 (VZCR); also elsewhere on the board
GND: C3.2, C7.2, C10.2, C20.2, C21.2, C42.2, C43.2, C44.2, C45.2, C46.2, C50.1, C53.1, R19.2, R20.2, R35.2, R36.2, U1.5 (GND), U6.4 (GND), U7.4 (GND), U9.4 (GND1), U10.4 (GND1), U17.5 (GND), U18.4 (GND1), U19.4 (GND1); also elsewhere on the board
unnamed: C39.1, TR2.4
unnamed: C41.1, TR4.4
unnamed: C39.2, D3.3 (COM)
unnamed: C27.1, C30.2, D3.2 (K), D7.1 (K), LR11.3 (IN), U13.1 (EN_A), U13.6 (V+), U13.8 (EN_B), Z1.1 (K)
unnamed: C41.2, D4.3 (COM)
unnamed: C49.1, C51.2, D4.2 (K), D8.1 (K), LR12.3 (IN), U22.1 (EN_A), U22.6 (V+), U22.8 (EN_B), Z32.1 (K)
unnamed: D9.2 (A), R27.2
unnamed: D10.2 (A), R30.2
unnamed: D30.2 (A), R43.2
unnamed: D31.2 (A), R46.2
unnamed: C23.1, LR11.1 (OUT), U9.8 (VDD2)
unnamed: C47.1, LR12.1 (OUT), U18.8 (VDD2)
unnamed: Q5.1 (G), R31.1, R32.1
unnamed: Q6.1 (G), R33.1, R34.1
unnamed: Q7.1 (G), R47.1, R48.1
unnamed: Q8.1 (G), R49.1, R50.1
unnamed: TR2.3, U6.1 (D1)
unnamed: TR2.1, U6.3 (D2)
unnamed: TR4.3, U7.1 (D1)
unnamed: TR4.1, U7.3 (D2)
unnamed: R29.1, U9.7 (VIA)
unnamed: R25.2, U9.6 (VOB)
unnamed: R28.2, U10.7 (VIA)
unnamed: R26.2, U10.6 (VOB)
unnamed: R26.1, U12.2 (IN_A), U12.4 (IN_B)
unnamed: R33.2, U12.7 (OUT_A)
unnamed: R34.2, U12.5 (OUT_B)
unnamed: R25.1, U13.2 (IN_A), U13.4 (IN_B)
unnamed: R31.2, U13.7 (OUT_A)
unnamed: R32.2, U13.5 (OUT_B)
unnamed: R42.1, U14.2 (IN_A), U14.4 (IN_B)
unnamed: R49.2, U14.7 (OUT_A)
unnamed: R50.2, U14.5 (OUT_B)
unnamed: R45.1, U18.7 (VIA)
unnamed: R41.2, U18.6 (VOB)
unnamed: R44.2, U19.7 (VIA)
unnamed: R42.2, U19.6 (VOB)
unnamed: R41.1, U22.2 (IN_A), U22.4 (IN_B)
unnamed: R47.2, U22.7 (OUT_A)
unnamed: R48.2, U22.5 (OUT_B)
unnamed: R27.1, R29.2, Z1.2 (A)
unnamed: R28.1, R30.1, Z2.2 (A)
unnamed: R43.1, R45.2, Z32.2 (A)
unnamed: R44.1, R46.1, Z33.2 (A)

Notes on the sheet:
HIGH VOLTAGE
LOW VOLTAGE
WARNING: Do not use TO-3P and certainly not old SOT83 or TO218 transistors here, as there is no clearance between adjacent low side switches and the metal tab is connected to each half bridge SWNODE, which can be at different potentials when each half bridge is used independently.
PP note: Logic Threshold for ADuM121 input should be 0.3Vin and 0.7Vin, which roughly translates to 1.5 and 3.5V. In addition to the 9V zener diode and 2V amber LED adds 11V to the logic threshold. So 14.5V to trigger Pgood and 12.5V to set it low. Can be fine-tuned with the current limit resistor,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

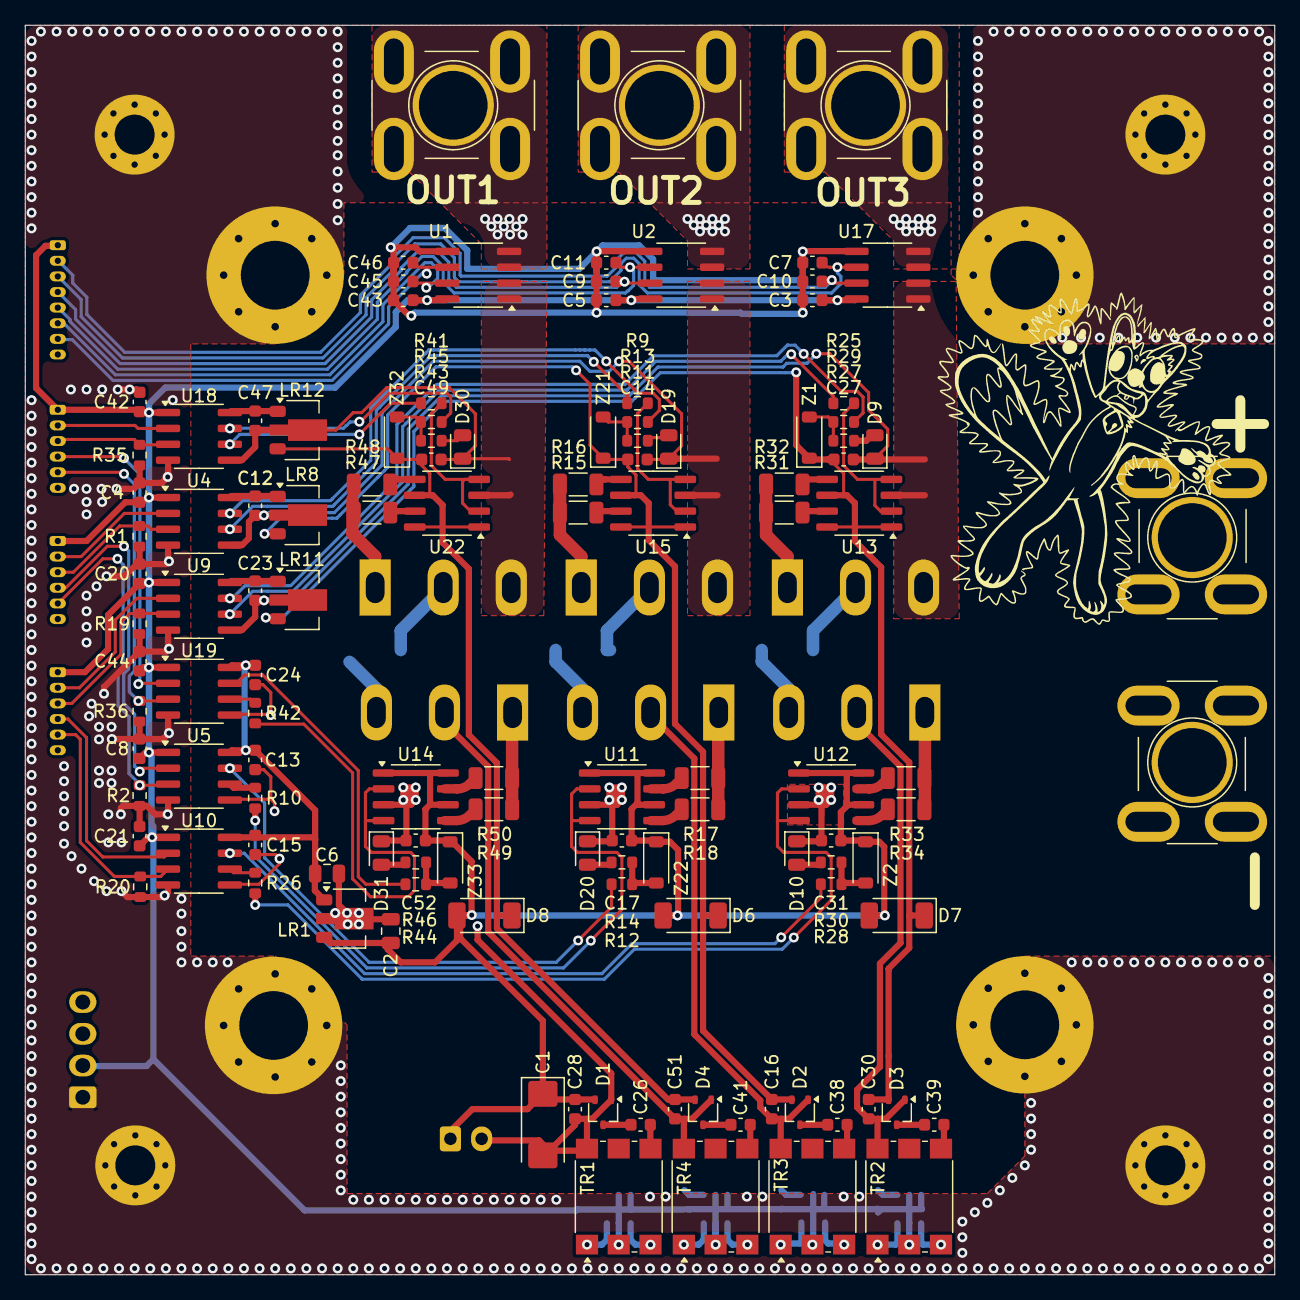
[picture p17: board three_half_bridges.kicad_pcb from above]

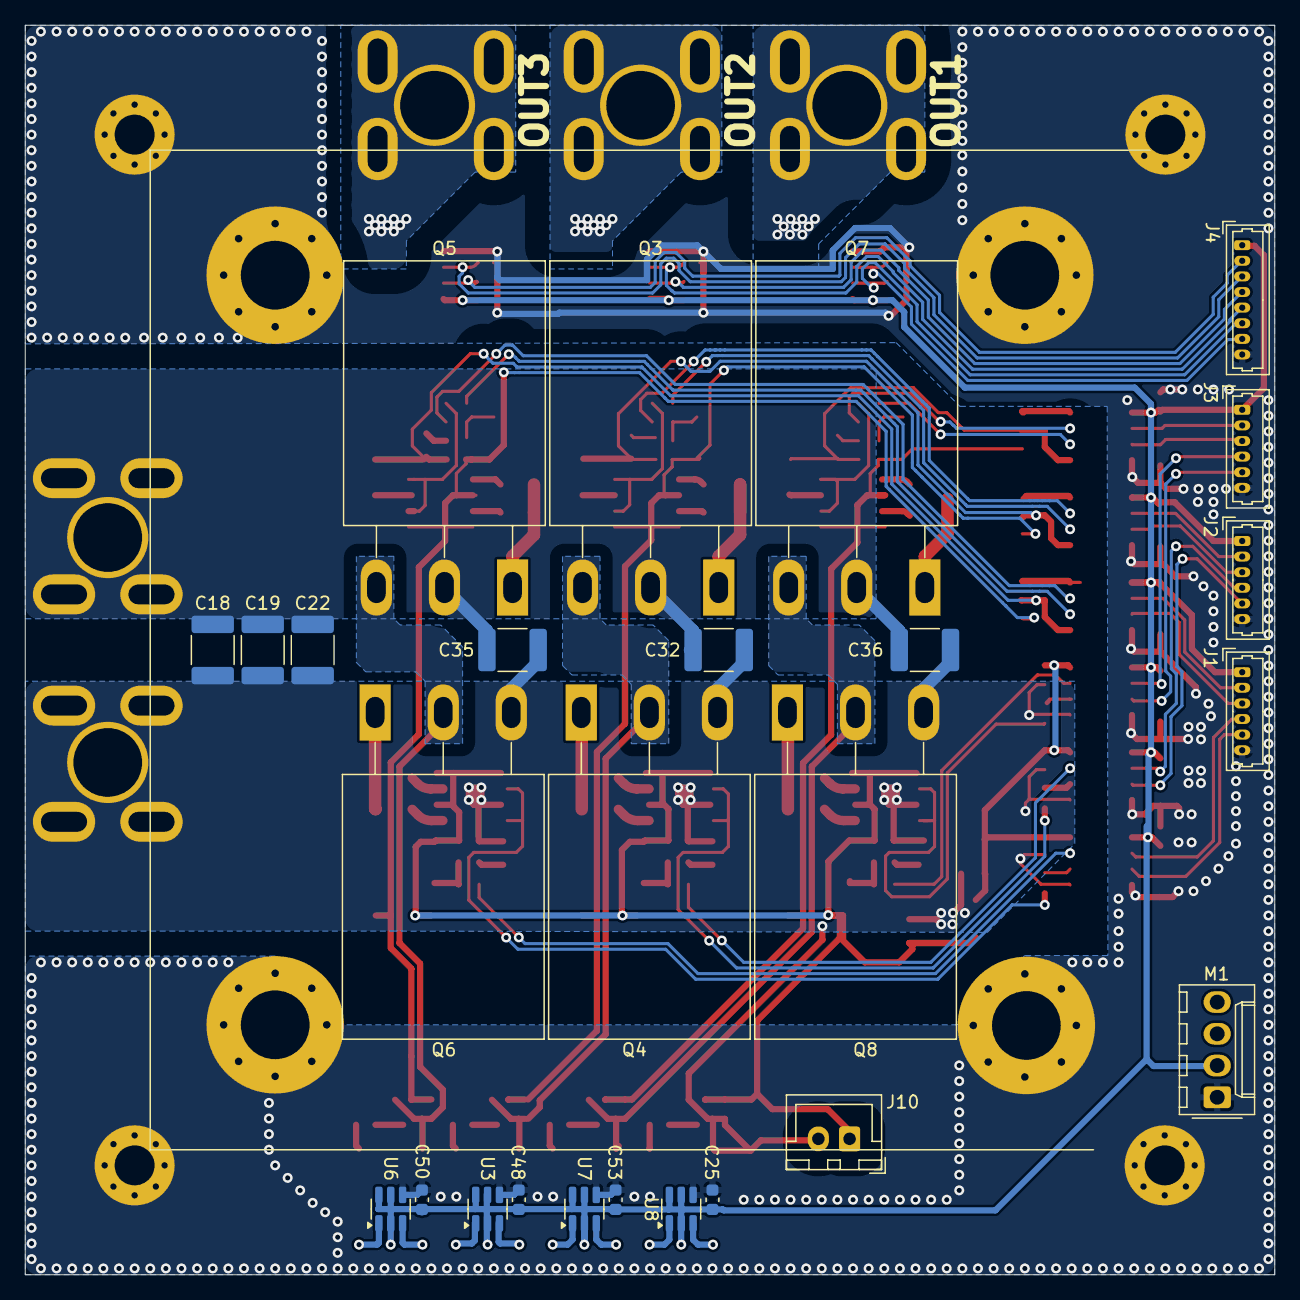
[picture p18: board three_half_bridges.kicad_pcb from below]

Board: 4 copper layers, 100.0 x 100.0 mm, 155 parts (26 on the bottom side), 100 nets.
