power-max/Three-Half-Bridges/(commit log)

2020-09-15 added KiCAD files
    [universal-half-bridge.kicad_pcb, universal-half-bridge.sch]
2022-08-12 Massive overhaul including a change in the scope of the project! Yeah I know this goes against the "atomic commits" philosophy of git, don't @ me!
    [Three-Half-Bridges-B_Cu.gbr, Three-Half-Bridges-B_Mask.gbr, Three-Half-Bridges-B_Paste.gbr, Three-Half-Bridges-B_Silkscreen.gbr, Three-Half-Bridges-Edge_Cuts.gbr, Three-Half-Bridges-F_Cu.gbr, Three-Half-Bridges-F_Mask.gbr, Three-Half-Bridges-F_Paste.gbr]
2023-01-17 cleanup (removed KiCad v5 legacy files)
    [Three-Half-Bridges.kicad_pcb, Three-Half-Bridges.kicad_sch, Three-Half-Bridges.sch, half-bridge.kicad_sch, half_bridge.kicad_sch, untitled.kicad_sch]
2023-01-17 added/corrected placeholder resistor values
    [Three-Half-Bridges.kicad_sch, half_bridge.kicad_sch]
2023-01-17 added infomation to title block, generated PDF of schematic
    [Three-Half-Bridges.kicad_sch, half_bridge.kicad_sch]
2023-01-17 updated gerber exports
    [Three-Half-Bridges-B_Cu.gbr, Three-Half-Bridges-B_Mask.gbr, Three-Half-Bridges-B_Paste.gbr, Three-Half-Bridges-B_Silkscreen.gbr, Three-Half-Bridges-Edge_Cuts.gbr, Three-Half-Bridges-F_Cu.gbr, Three-Half-Bridges-F_Mask.gbr, Three-Half-Bridges-F_Paste.gbr]
2024-11-10 updated the 3 half bridges project, the dodgybrothers positive negative SR latch idea turned out to be retarded and didn't work at all.
    [Three-Half-Bridges-B_Cu.gbr, Three-Half-Bridges-B_Mask.gbr, Three-Half-Bridges-B_Paste.gbr, Three-Half-Bridges-B_Silkscreen.gbr, Three-Half-Bridges-Edge_Cuts.gbr, Three-Half-Bridges-F_Cu.gbr, Three-Half-Bridges-F_Mask.gbr, Three-Half-Bridges-F_Paste.gbr]
2024-11-25 Updated LDO footrprint to use the SOT89 LM78L05 (issue 10); moved high side local regulators closer to digital isolator ICs (issue 10); pushed digital isolator ICs further to the allow room for LRs (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
    [halfbridge.kicad_sch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]
2024-11-25 turned into a 4 layer board for improved EMI and lower parasitics, should still be 100% compatible as a 2 layer board!
    [three_half_bridges-B_Cu.gbr, three_half_bridges-B_Mask.gbr, three_half_bridges-B_Paste.gbr, three_half_bridges-B_SilkS.gbr, three_half_bridges-B_Silkscreen.gbr, three_half_bridges-Edge_Cuts.gbr, three_half_bridges-F_Cu.gbr, three_half_bridges-F_Mask.gbr]
2024-11-25 moved silkscreen for HVDC input and added additional 5VDC for the low voltage primary input
    [three_half_bridges-B_Cu.gbr, three_half_bridges-B_Mask.gbr, three_half_bridges-B_Paste.gbr, three_half_bridges-B_Silkscreen.gbr, three_half_bridges-Edge_Cuts.gbr, three_half_bridges-F_Cu.gbr, three_half_bridges-F_Mask.gbr, three_half_bridges-F_Paste.gbr]
2024-11-25 forgot to save and close prior to last commit
    [halfbridge.kicad_sch, three_half_bridges.kicad_pcb, three_half_bridges.kicad_sch]
2024-11-25 updated footprint for terminal blocks to use AMT0450028DB0000G‎
    [three_half_bridges-B_Cu.gbr, three_half_bridges-B_Mask.gbr, three_half_bridges-B_Paste.gbr, three_half_bridges-B_Silkscreen.gbr, three_half_bridges-Edge_Cuts.gbr, three_half_bridges-F_Cu.gbr, three_half_bridges-F_Mask.gbr, three_half_bridges-F_Paste.gbr]
2024-11-25 Delete ~three_half_bridges.kicad_pcb.lck
    not sure why this got added to the staging area, may need to update .gitignore
2024-11-25 fixed the accidentally flipped terminal block posistive terminal
    [halfbridge.kicad_sch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]
2024-12-23 beginings of the implementation of the 10 open issues
    [halfbridge.kicad_sch, three_half_bridges.kicad_sch]
2025-03-26 fixed many issues from previous itteration, added design rule checks to enforce minumum 2mm clearence between LV and HV side
    [buck-converter.kicad_sch, halfbridge.kicad_sch, logic.kicad_sch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]
2025-03-26 updated PDF export schematics
